muren400/flipper/README.md

# flipper
Currently flipper is just a flip dot clock. display.h could be used for all kinds of flip dot applications though.

## Hardware
Make sure to import https://github.com/espressif/kicad-libraries/ to open the kicad project
