muren400/flipper/hardware/flipdot.kicad_pcb

## KiCad design hardware/flipdot.kicad_pcb (2023-06-14)

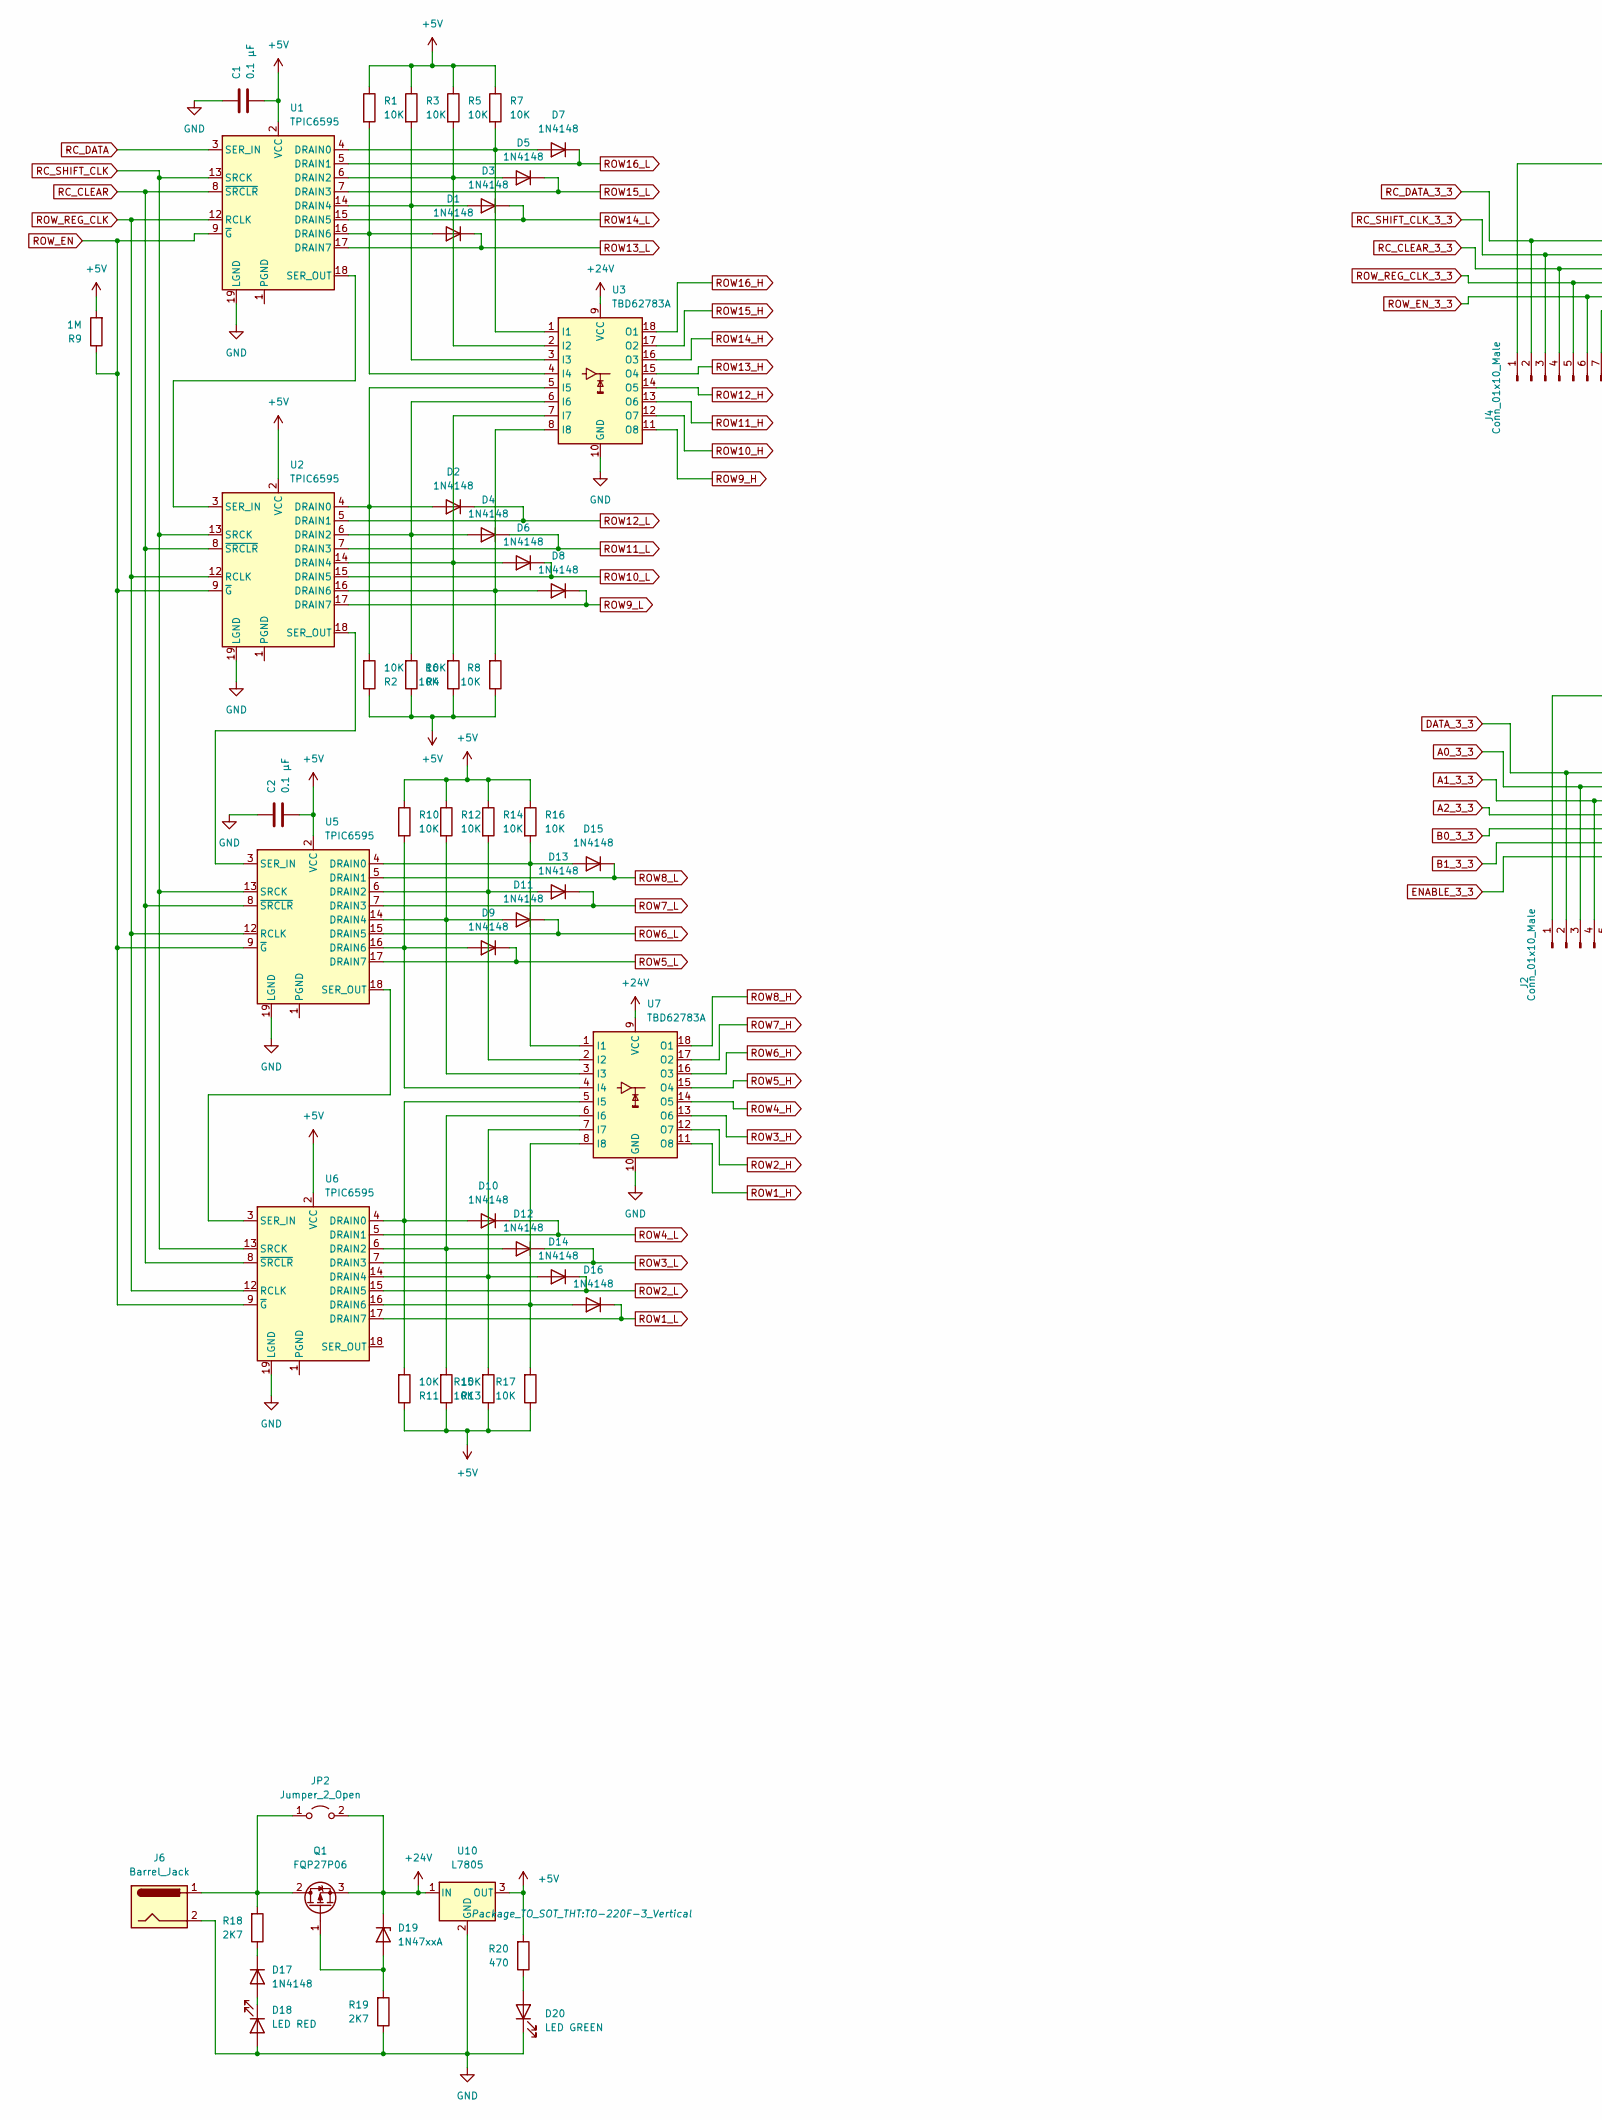
[picture p1: schematic flipdot.kicad_sch, part in row 1, column 1]

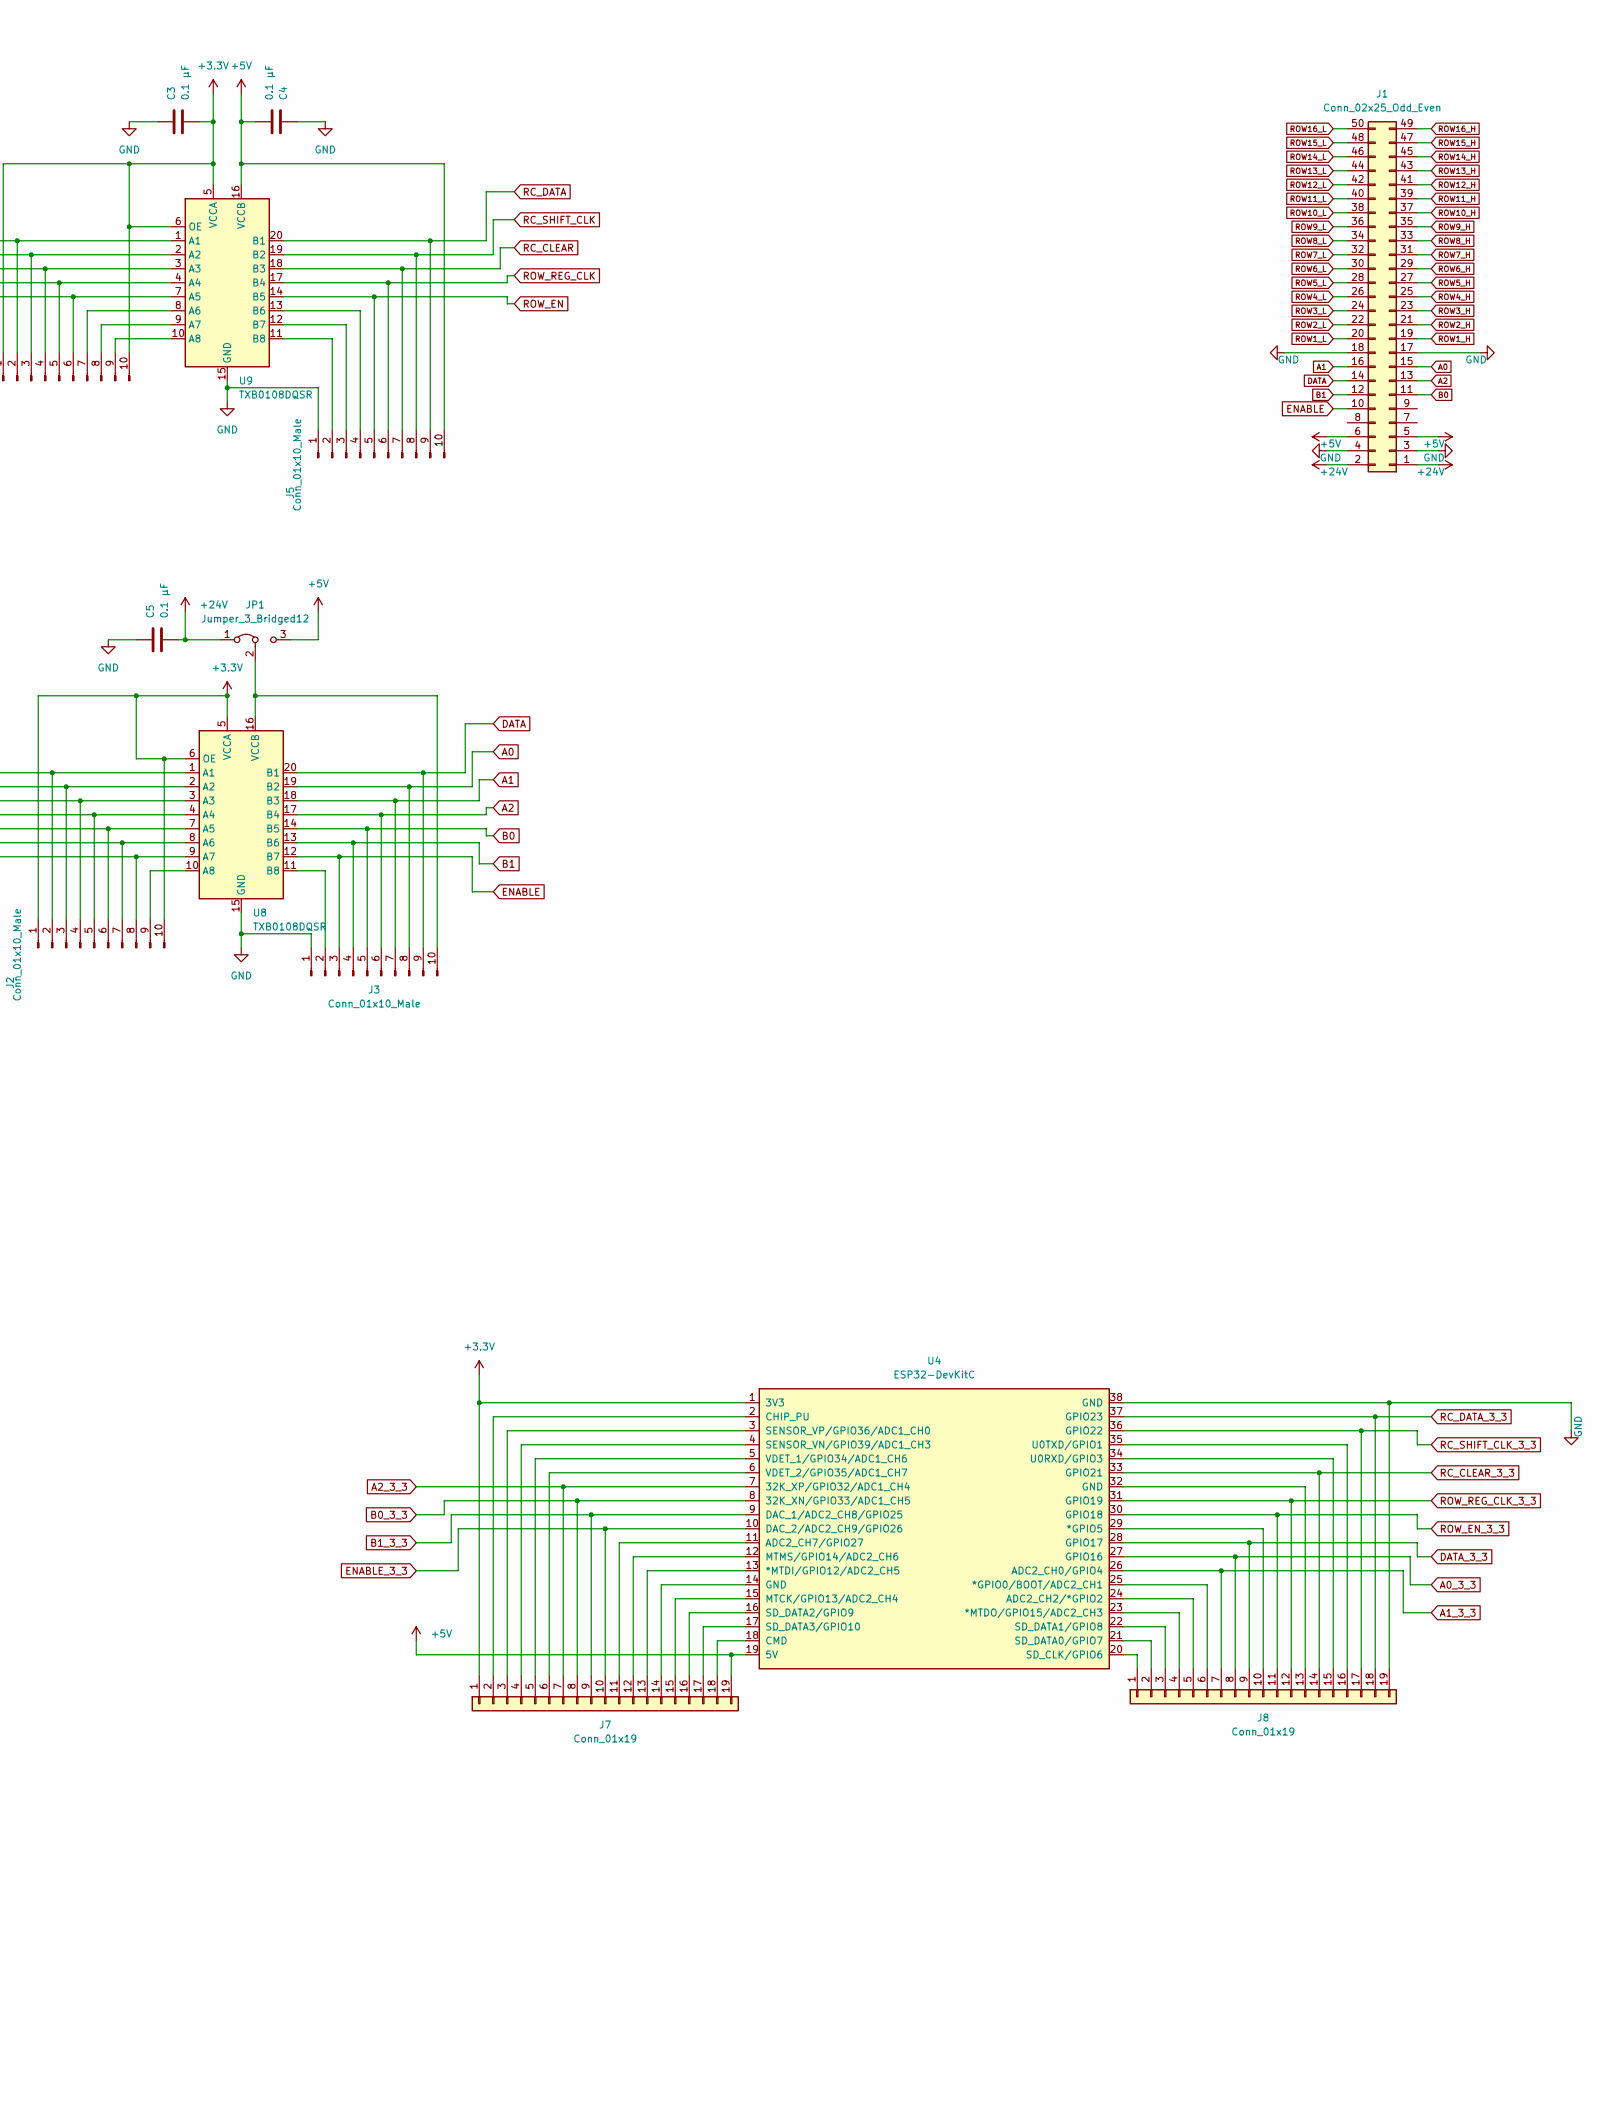
[picture p2: schematic flipdot.kicad_sch, part in row 1, column 2]

Parts:
C1, C2, C3, C4, C5: 0.1 µF; C_Rect_L7.2mm_W2.5mm_P5.00mm_FKS2_FKP2_MKS2_MKP2
D1, D2, D3, D4, D5, D6, D7, D8, D9, D10, D11, D12, D13, D14, D15, D16, D17: 1N4148; D_DO-35_SOD27_P7.62mm_Horizontal
D18: LED RED; LED_D3.0mm
D19: 1N47xxA; D_DO-41_SOD81_P10.16mm_Horizontal
D20: LED GREEN; LED_D3.0mm
J1: Conn_02x25_Odd_Even; PinSocket_2x25_P2.54mm_Vertical
J2, J3, J4, J5: Conn_01x10_Male; PinSocket_1x10_P2.54mm_Vertical
J6: Barrel_Jack; BarrelJack_CUI_PJ-063AH_Horizontal
J7, J8: Conn_01x19; PinHeader_1x19_P2.54mm_Vertical
JP1: Jumper_3_Bridged12; PinHeader_1x03_P2.54mm_Vertical
JP2: Jumper_2_Open; PinHeader_1x02_P2.54mm_Vertical
Q1: FQP27P06; TO-220-3_Vertical
R1, R2, R3, R4, R5, R6, R7, R8, R10, R11, R12, R13, R14, R15, R16, R17: 10K; R_Axial_DIN0204_L3.6mm_D1.6mm_P7.62mm_Horizontal
R9: 1M; R_Axial_DIN0204_L3.6mm_D1.6mm_P7.62mm_Horizontal
R18, R19: 2K7; R_Axial_DIN0204_L3.6mm_D1.6mm_P7.62mm_Horizontal
R20: 470; R_Axial_DIN0204_L3.6mm_D1.6mm_P7.62mm_Horizontal
U1, U2, U5, U6: TPIC6595; DIP-20_W7.62mm_Socket_LongPads
U3, U7: TBD62783A; DIP-18_W7.62mm_Socket_LongPads
U4: ESP32-DevKitC
U8, U9: TXB0108DQSR; USON-20_2x4mm_P0.4mm
U10: L7805; TO-220F-3_Vertical

Connections:
+3.3V: C3.2, J2.1, J2.10, J4.1, J4.10, J7.1, U4.1 (3V3), U8.5 (VCCA), U8.6 (OE), U9.5 (VCCA), U9.6 (OE)
+5V: C1.2, C2.2, C4.2, J1.5, J1.6, J5.10, J7.19, JP1.3 (B), R1.1, R2.1, R3.1, R4.1, R5.1, R6.1, R7.1, R8.1, R9.2, R10.1, R11.1, R12.1, R13.1, R14.1, R15.1, R16.1, R17.1, R20.2, U1.2 (VCC), U2.2 (VCC), U4.19 (5V), U5.2 (VCC), U6.2 (VCC), U9.16 (VCCB), U10.3 (OUT)
+24V: C5.2, D19.1 (K), J1.1, J1.2, JP1.1 (A), JP2.2 (B), Q1.3 (S), U3.9 (VCC), U7.9 (VCC), U10.1 (IN)
A0: J1.15, J3.8, U8.19 (B2)
A0_3_3: J2.3, J8.8, U4.27 (GPIO16), U8.2 (A2)
A1: J1.16, J3.7, U8.18 (B3)
A1_3_3: J2.4, J8.7, U4.26 (ADC2_CH0/GPIO4), U8.3 (A3)
A2: J1.13, J3.6, U8.17 (B4)
A2_3_3: J2.5, J7.7, U4.7 (32K_XP/GPIO32/ADC1_CH4), U8.4 (A4)
B0: J1.11, J3.5, U8.14 (B5)
B0_3_3: J2.6, J7.8, U4.8 (32K_XN/GPIO33/ADC1_CH5), U8.7 (A5)
B1: J1.12, J3.4, U8.13 (B6)
B1_3_3: J2.7, J7.9, U4.9 (DAC_1/ADC2_CH8/GPIO25), U8.8 (A6)
DATA: J1.14, J3.9, U8.20 (B1)
DATA_3_3: J2.2, J8.9, U4.28 (GPIO17), U8.1 (A1)
ENABLE: J1.10, J3.3, U8.12 (B7)
ENABLE_3_3: J2.8, J7.10, U4.10 (DAC_2/ADC2_CH9/GPIO26), U8.9 (A7)
GND: C1.1, C2.1, C3.1, C4.1, C5.1, D18.2 (A), D20.1 (K), J1.3, J1.4, J1.17, J1.18, J3.1, J5.1, J6.2, J8.19, R19.1, U1.19 (LGND), U2.19 (LGND), U3.10 (GND), U4.38 (GND), U5.19 (LGND), U6.19 (LGND), U7.10 (GND), U8.15 (GND), U9.15 (GND), U10.2 (GND)
unnamed: D1.2 (A), R1.2, U1.16 (DRAIN6), U3.4 (I4)
unnamed: D2.2 (A), R2.2, U2.4 (DRAIN0), U3.5 (I5)
unnamed: D3.2 (A), R3.2, U1.14 (DRAIN4), U3.3 (I3)
unnamed: D4.2 (A), R4.2, U2.6 (DRAIN2), U3.6 (I6)
unnamed: D5.2 (A), R5.2, U1.6 (DRAIN2), U3.2 (I2)
unnamed: D6.2 (A), R6.2, U2.14 (DRAIN4), U3.7 (I7)
unnamed: D7.2 (A), R7.2, U1.4 (DRAIN0), U3.1 (I1)
unnamed: D8.2 (A), R8.2, U2.16 (DRAIN6), U3.8 (I8)
unnamed: D9.2 (A), R10.2, U5.16 (DRAIN6), U7.4 (I4)
unnamed: D10.2 (A), R11.2, U6.4 (DRAIN0), U7.5 (I5)
unnamed: D11.2 (A), R12.2, U5.14 (DRAIN4), U7.3 (I3)
unnamed: D12.2 (A), R13.2, U6.6 (DRAIN2), U7.6 (I6)
unnamed: D13.2 (A), R14.2, U5.6 (DRAIN2), U7.2 (I2)
unnamed: D14.2 (A), R15.2, U6.14 (DRAIN4), U7.7 (I7)
unnamed: D15.2 (A), R16.2, U5.4 (DRAIN0), U7.1 (I1)
unnamed: D16.2 (A), R17.2, U6.16 (DRAIN6), U7.8 (I8)
unnamed: D17.2 (A), D18.1 (K)
unnamed: D17.1 (K), R18.1
unnamed: D19.2 (A), Q1.1 (G), R19.2
unnamed: D20.2 (A), R20.1
unnamed: J2.9, U8.10 (A8)
unnamed: J3.2, U8.11 (B8)
unnamed: J3.10, JP1.2 (C), U8.16 (VCCB)
unnamed: J4.7, U9.8 (A6)
unnamed: J4.8, U9.9 (A7)
unnamed: J4.9, U9.10 (A8)
unnamed: J5.2, U9.11 (B8)
unnamed: J5.3, U9.12 (B7)
unnamed: J5.4, U9.13 (B6)
unnamed: J7.2, U4.2 (CHIP_PU)
unnamed: J7.3, U4.3 (SENSOR_VP/GPIO36/ADC1_CH0)
unnamed: J7.4, U4.4 (SENSOR_VN/GPIO39/ADC1_CH3)
unnamed: J7.5, U4.5 (VDET_1/GPIO34/ADC1_CH6)
unnamed: J7.6, U4.6 (VDET_2/GPIO35/ADC1_CH7)
unnamed: J7.11, U4.11 (ADC2_CH7/GPIO27)
unnamed: J7.12, U4.12 (MTMS/GPIO14/ADC2_CH6)
unnamed: J7.13, U4.13 (*MTDI/GPIO12/ADC2_CH5)
unnamed: J7.14, U4.14 (GND)
unnamed: J7.15, U4.15 (MTCK/GPIO13/ADC2_CH4)
unnamed: J7.16, U4.16 (SD_DATA2/GPIO9)
unnamed: J7.17, U4.17 (SD_DATA3/GPIO10)
unnamed: J7.18, U4.18 (CMD)
unnamed: J8.1, U4.20 (SD_CLK/GPIO6)
unnamed: J8.2, U4.21 (SD_DATA0/GPIO7)
unnamed: J8.3, U4.22 (SD_DATA1/GPIO8)
unnamed: J8.4, U4.23 (*MTDO/GPIO15/ADC2_CH3)
unnamed: J8.5, U4.24 (ADC2_CH2/*GPIO2)
unnamed: J8.6, U4.25 (*GPIO0/BOOT/ADC2_CH1)
unnamed: J8.10, U4.29 (*GPIO5)
unnamed: J8.13, U4.32 (GND)
unnamed: J8.15, U4.34 (U0RXD/GPIO3)
unnamed: J8.16, U4.35 (U0TXD/GPIO1)
unnamed: J6.1, JP2.1 (A), Q1.2 (D), R18.2
unnamed: U1.1 (PGND), U1.10 (PGND), U1.11 (PGND), U1.20 (PGND)
unnamed: U1.18 (SER_OUT), U2.3 (SER_IN)
unnamed: U2.1 (PGND), U2.10 (PGND), U2.11 (PGND), U2.20 (PGND)
unnamed: U2.18 (SER_OUT), U5.3 (SER_IN)
unnamed: U5.1 (PGND), U5.10 (PGND), U5.11 (PGND), U5.20 (PGND)
unnamed: U5.18 (SER_OUT), U6.3 (SER_IN)
unnamed: U6.1 (PGND), U6.10 (PGND), U6.11 (PGND), U6.20 (PGND)
RC_CLEAR: J5.7, U1.8 (~SRCLR), U2.8 (~SRCLR), U5.8 (~SRCLR), U6.8 (~SRCLR), U9.18 (B3)
RC_CLEAR_3_3: J4.4, J8.14, U4.33 (GPIO21), U9.3 (A3)
RC_DATA: J5.9, U1.3 (SER_IN), U9.20 (B1)
RC_DATA_3_3: J4.2, J8.18, U4.37 (GPIO23), U9.1 (A1)
RC_SHIFT_CLK: J5.8, U1.13 (SRCK), U2.13 (SRCK), U5.13 (SRCK), U6.13 (SRCK), U9.19 (B2)
RC_SHIFT_CLK_3_3: J4.3, J8.17, U4.36 (GPIO22), U9.2 (A2)
ROW1_H: J1.19, U7.11 (O8)
ROW1_L: D16.1 (K), J1.20, U6.17 (DRAIN7)
ROW2_H: J1.21, U7.12 (O7)
ROW2_L: D14.1 (K), J1.22, U6.15 (DRAIN5)
ROW3_H: J1.23, U7.13 (O6)
ROW3_L: D12.1 (K), J1.24, U6.7 (DRAIN3)
ROW4_H: J1.25, U7.14 (O5)
ROW4_L: D10.1 (K), J1.26, U6.5 (DRAIN1)
ROW5_H: J1.27, U7.15 (O4)
ROW5_L: D9.1 (K), J1.28, U5.17 (DRAIN7)
ROW6_H: J1.29, U7.16 (O3)
ROW6_L: D11.1 (K), J1.30, U5.15 (DRAIN5)
ROW7_H: J1.31, U7.17 (O2)
ROW7_L: D13.1 (K), J1.32, U5.7 (DRAIN3)
ROW8_H: J1.33, U7.18 (O1)
ROW8_L: D15.1 (K), J1.34, U5.5 (DRAIN1)
ROW9_H: J1.35, U3.11 (O8)
ROW9_L: D8.1 (K), J1.36, U2.17 (DRAIN7)
ROW10_H: J1.37, U3.12 (O7)
ROW10_L: D6.1 (K), J1.38, U2.15 (DRAIN5)
ROW11_H: J1.39, U3.13 (O6)
ROW11_L: D4.1 (K), J1.40, U2.7 (DRAIN3)
ROW12_H: J1.41, U3.14 (O5)
ROW12_L: D2.1 (K), J1.42, U2.5 (DRAIN1)
ROW13_H: J1.43, U3.15 (O4)
ROW13_L: D1.1 (K), J1.44, U1.17 (DRAIN7)
ROW14_H: J1.45, U3.16 (O3)
ROW14_L: D3.1 (K), J1.46, U1.15 (DRAIN5)
ROW15_H: J1.47, U3.17 (O2)
ROW15_L: D5.1 (K), J1.48, U1.7 (DRAIN3)
ROW16_H: J1.49, U3.18 (O1)
ROW16_L: D7.1 (K), J1.50, U1.5 (DRAIN1)
ROW_EN: J5.5, R9.1, U1.9 (~G), U2.9 (~G), U5.9 (~G), U6.9 (~G), U9.14 (B5)
ROW_EN_3_3: J4.6, J8.11, U4.30 (GPIO18), U9.7 (A5)
ROW_REG_CLK: J5.6, U1.12 (RCLK), U2.12 (RCLK), U5.12 (RCLK), U6.12 (RCLK), U9.17 (B4)
ROW_REG_CLK_3_3: J4.5, J8.12, U4.31 (GPIO19), U9.4 (A4)

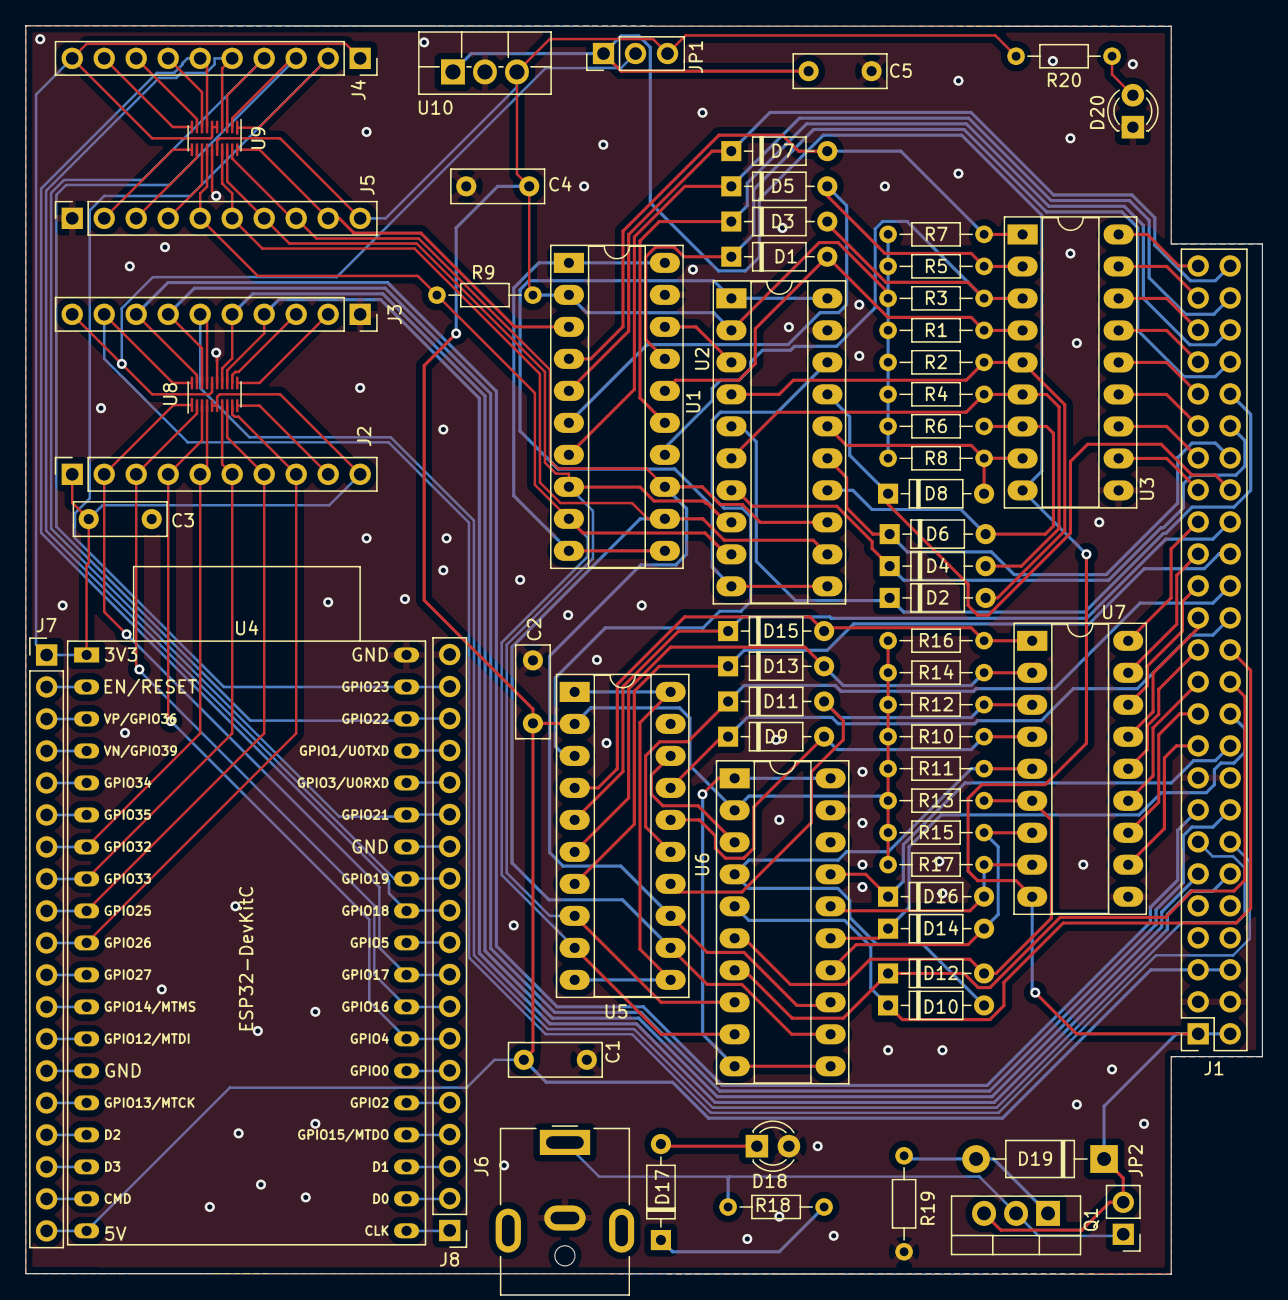
[picture p3: board flipdot.kicad_pcb from above]

Board: 2 copper layers, 98.2 x 99.1 mm, 66 parts (0 on the bottom side), 120 nets.
