muren400/flipper/software/flipper/characters.h

#ifndef CHARACTERS_H
#define CHARACTERS_H

#define DEFAULT_CHARACTERS

#include "flipper.h"
static const uint8_t characters[] = {
#ifdef DEFAULT_CHARACTERS
    // zero
    0b01110,
    0b11111,
    0b11011,
    0b11011,
    0b11011,
    0b11011,
    0b11011,
    0b11011,
    0b11011,
    0b11111,
    0b01110,
    // one
    0b00010,
    0b00011,
    0b00011,
    0b00011,
    0b00011,
    0b00011,
    0b00011,
    0b00011,
    0b00011,
    0b00011,
    0b00010,
    // two
    0b01110,
    0b11111,
    0b00011,
    0b00011,
    0b01111,
    0b11111,
    0b11110,
    0b11000,
    0b11000,
    0b11111,
    0b01110,
    // three
    0b01110,
    0b11111,
    0b00011,
    0b00011,
    0b00111,
    0b01110,
    0b00111,
    0b00011,
    0b00011,
    0b11111,
    0b01110,
    // four
    0b01010,
    0b11011,
    0b11011,
    0b11011,
    0b11011,
    0b11111,
    0b01111,
    0b00011,
    0b00011,
    0b00011,
    0b00010,
    // five
    0b01110,
    0b11111,
    0b11000,
    0b11000,
    0b11110,
    0b11111,
    0b01111,
    0b00011,
    0b00011,
    0b11111,
    0b01110,
    // six
    0b01110,
    0b11100,
    0b11000,
    0b11000,
    0b11110,
    0b11111,
    0b11011,
    0b11011,
    0b11011,
    0b11111,
    0b01110,
    // seven
    0b01110,
    0b11111,
    0b00011,
    0b00011,
    0b00011,
    0b00011,
    0b00011,
    0b00011,
    0b00011,
    0b00011,
    0b00010,
    // eight
    0b01110,
    0b11111,
    0b11011,
    0b11011,
    0b11111,
    0b01110,
    0b11111,
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
    0b11110,
    0b11111,
    0b11011,
    0b11011,
    0b11011,
// S
// T
// U
// V
// W
// X
// Y
// Z
// [
// backslash
// ]
// ^
// _
// `
// a
// b
// c
// d
// e
// f
// g
// h
// i
// j
// k
// l
// m
// n
// o
// p
// q
// r
// s
// t
// u
// v
// w
// x
// y
// z
#endif
};

#endif
